chocotov1/TinyFanContoller/(commit log)

2019-09-15 Power saving by connecting speed control potentiometer to pin instead of vcc.
    Saves 400 uA at 4 V with 10 K Ohm (during sleep alone!).
2019-09-17 Custom 25 kHz PWM frequency when the chip runs at 1 MHz. Before PWM was 32 kHz when running at 8 MHz (using modified TCCROB: millis() and delay() were broken doing this).
    [TinyFanController.ino]
2019-09-19 Added scope traces.
